ilyas9461/electrical-detection-helmet/images/Deney_AntenElektromanyetikGerilim.jpg

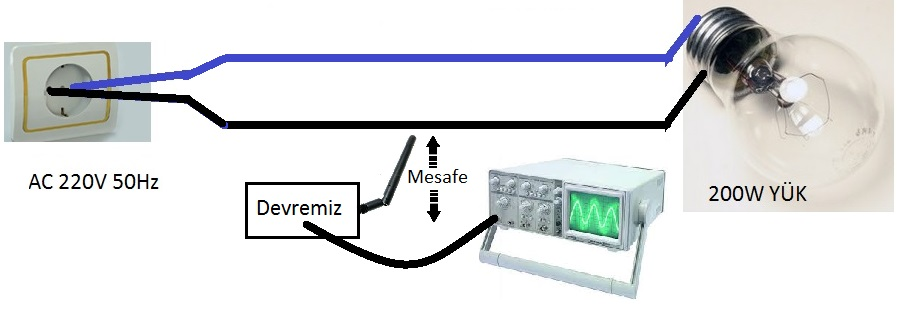
images/Deney_AntenElektromanyetikGerilim.jpg
