ilyas9461/electrical-detection-helmet/images/ElkAlgilayanKask_FritzingCizimi_bb.jpg

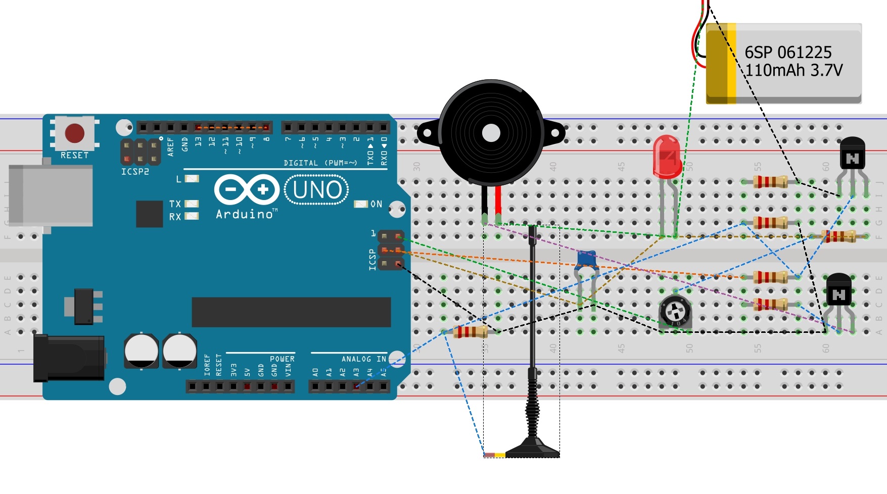
images/ElkAlgilayanKask_FritzingCizimi_bb.jpg
