ilyas9461/electrical-detection-helmet/images/ElkAlgilayanKask_FritzingCizimi_boardPrnt.jpg

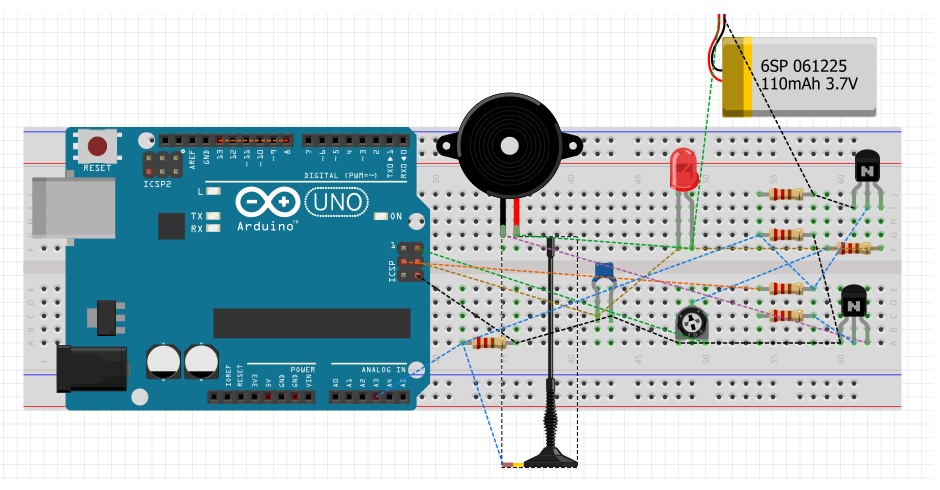
images/ElkAlgilayanKask_FritzingCizimi_boardPrnt.jpg
