ilyas9461/electrical-detection-helmet/images/IMG_20151222_125635.jpg

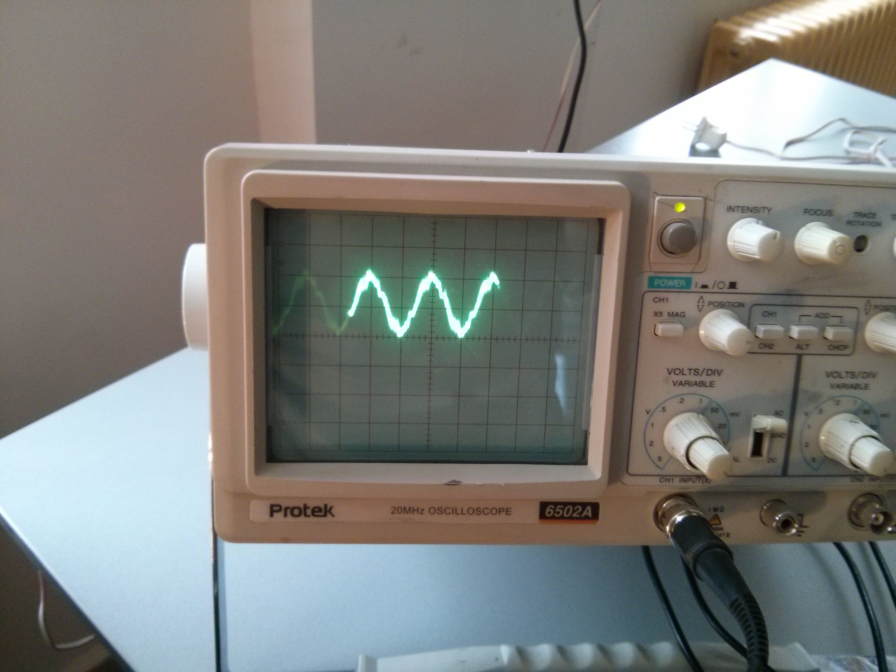
images/IMG_20151222_125635.jpg
